null422303/board-rescuer-deck/paper/figures/fig6_detection.png

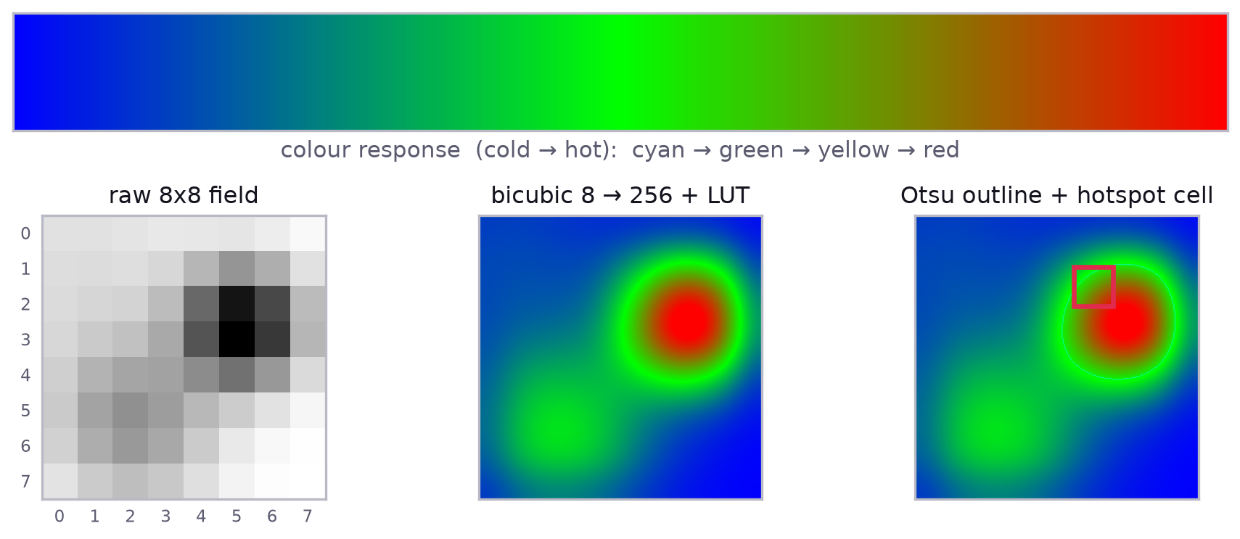
paper/figures/fig6_detection.png
