null422303/board-rescuer-deck/paper/photos/1792234036968.jpg

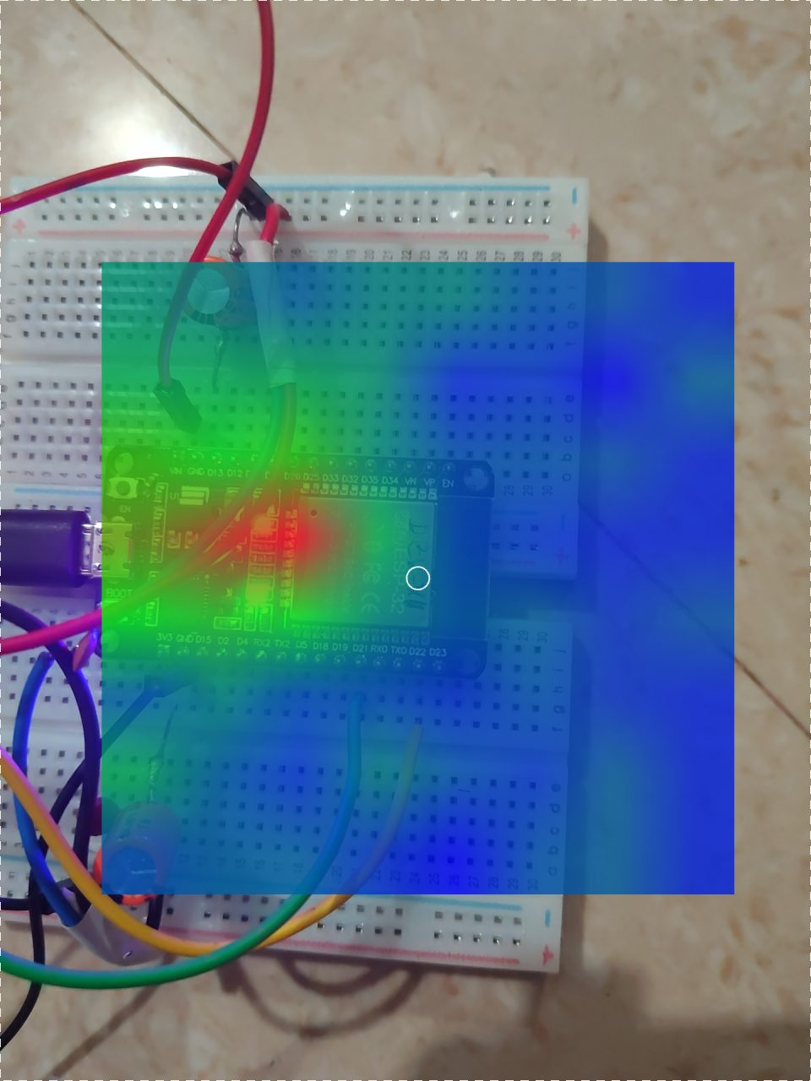
paper/photos/1792234036968.jpg
