null422303/board-rescuer-deck/assets/fx/astro-blocks.gif

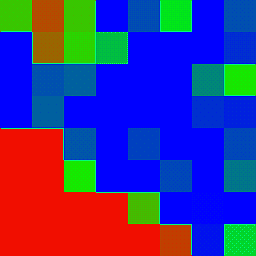
assets/fx/astro-blocks.gif
