null422303/board-rescuer-deck/assets/fx/astro-contour.gif

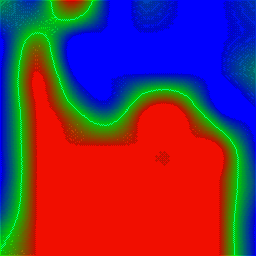
assets/fx/astro-contour.gif
