null422303/board-rescuer-deck/assets/fx/astro-sharp.gif

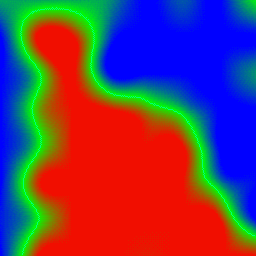
assets/fx/astro-sharp.gif
