null422303/board-rescuer-deck/assets/fx/plain-blocks.gif

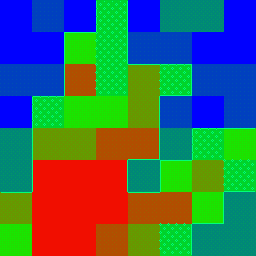
assets/fx/plain-blocks.gif
