null422303/board-rescuer-deck/assets/fx/plain-contour.gif

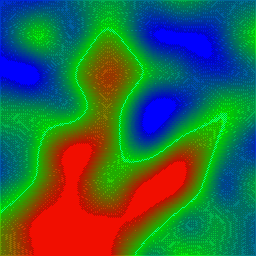
assets/fx/plain-contour.gif
