null422303/board-rescuer-deck/assets/fx/plain-sharp.gif

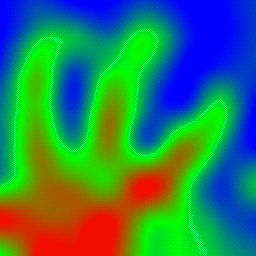
assets/fx/plain-sharp.gif
