null422303/board-rescuer-deck/assets/og.png

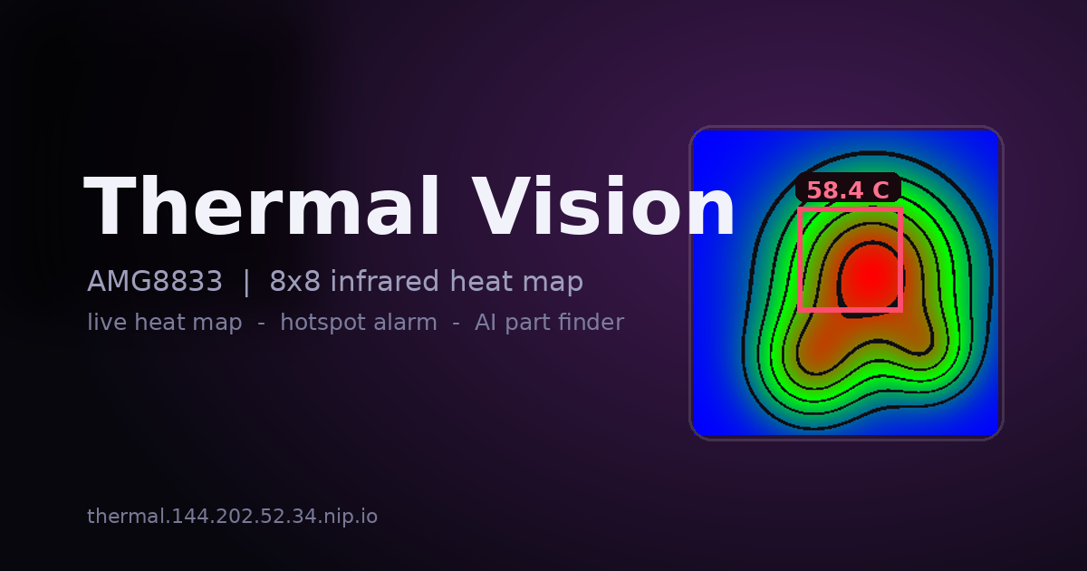
assets/og.png
