null422303/board-rescuer-deck/paper/figures/col_injection.png

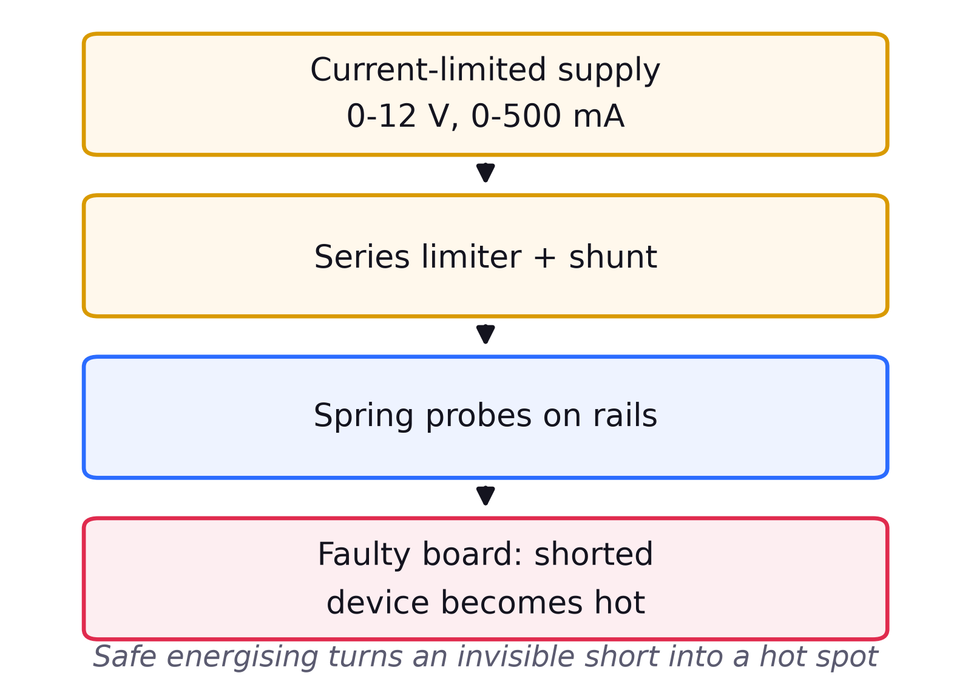
paper/figures/col_injection.png
