null422303/board-rescuer-deck/paper/figures/col_packet.png

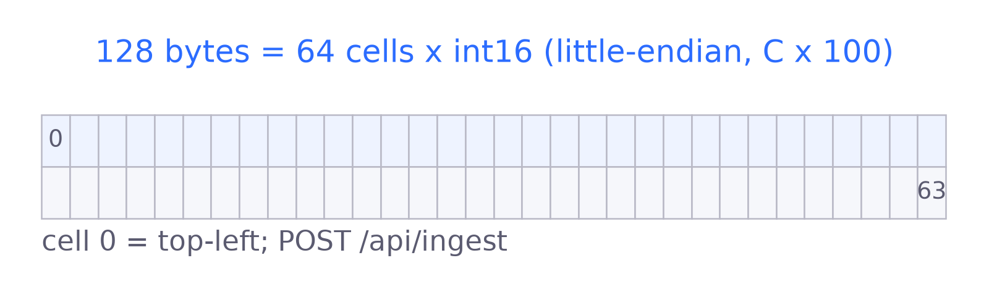
paper/figures/col_packet.png
