null422303/board-rescuer-deck/paper/figures/col_pipeline.png

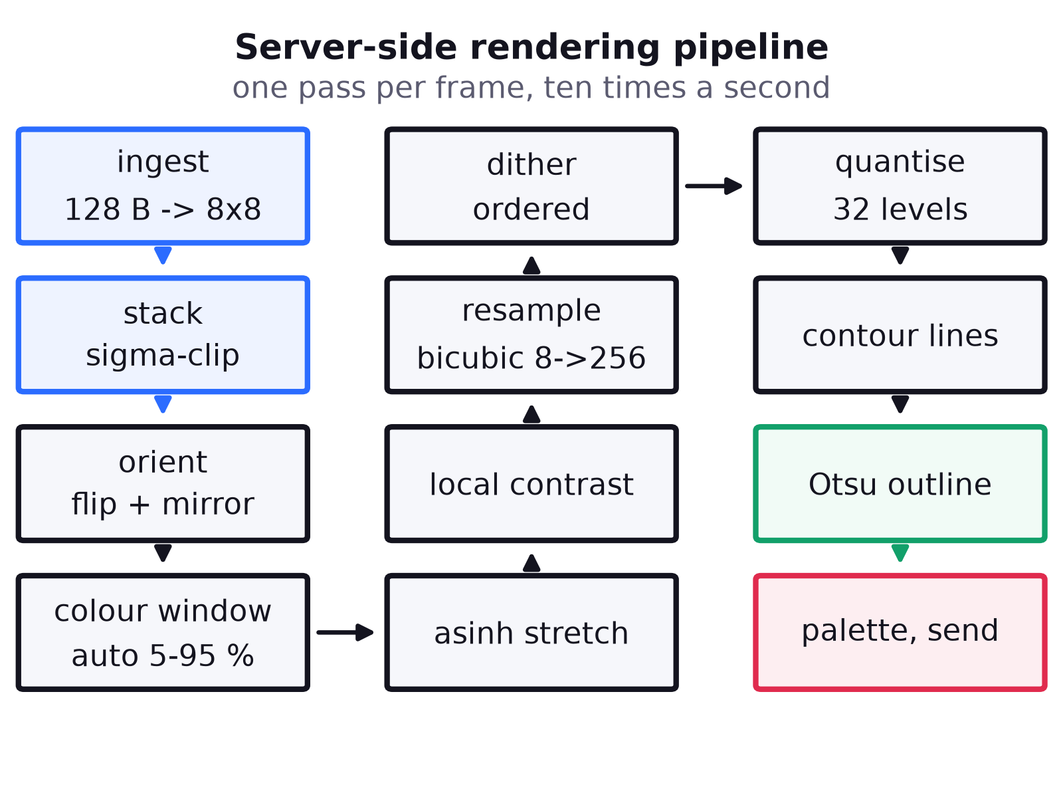
paper/figures/col_pipeline.png
