null422303/board-rescuer-deck/paper/figures/col_schematic.png

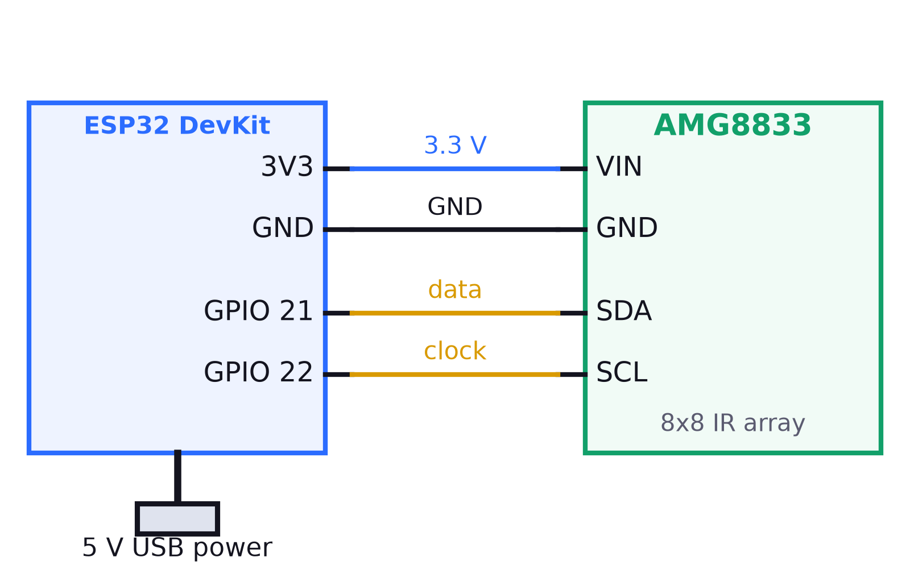
paper/figures/col_schematic.png
