null422303/board-rescuer-deck/paper/figures/fig1_architecture.png

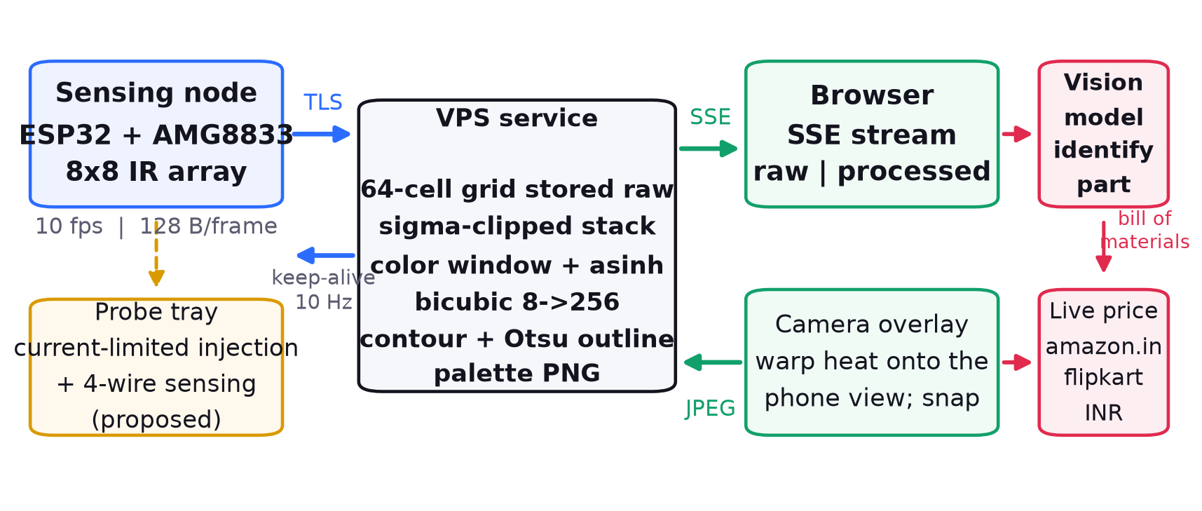
paper/figures/fig1_architecture.png
