null422303/board-rescuer-deck/paper/figures/fig2_schematic.png

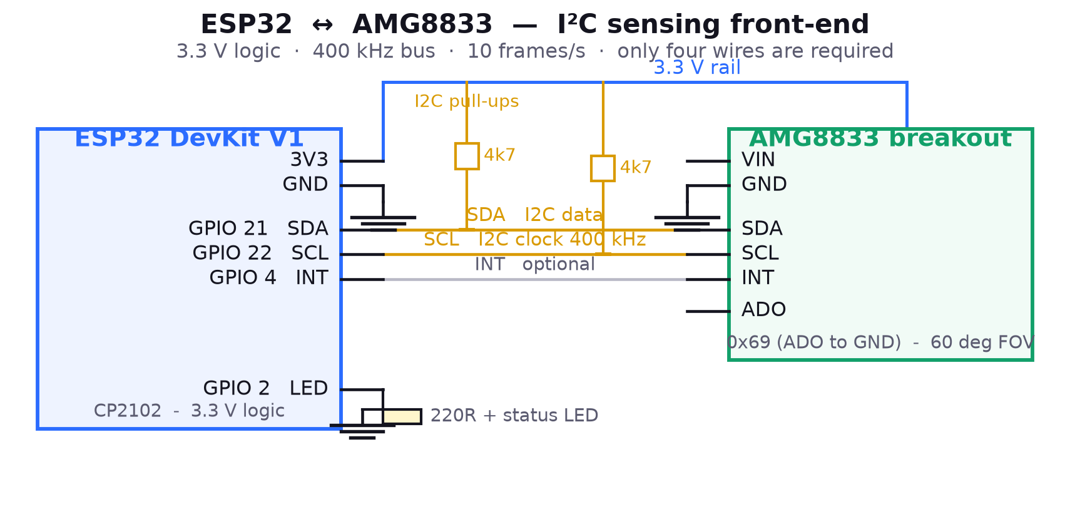
paper/figures/fig2_schematic.png
