null422303/board-rescuer-deck/paper/figures/fig3_injection.png

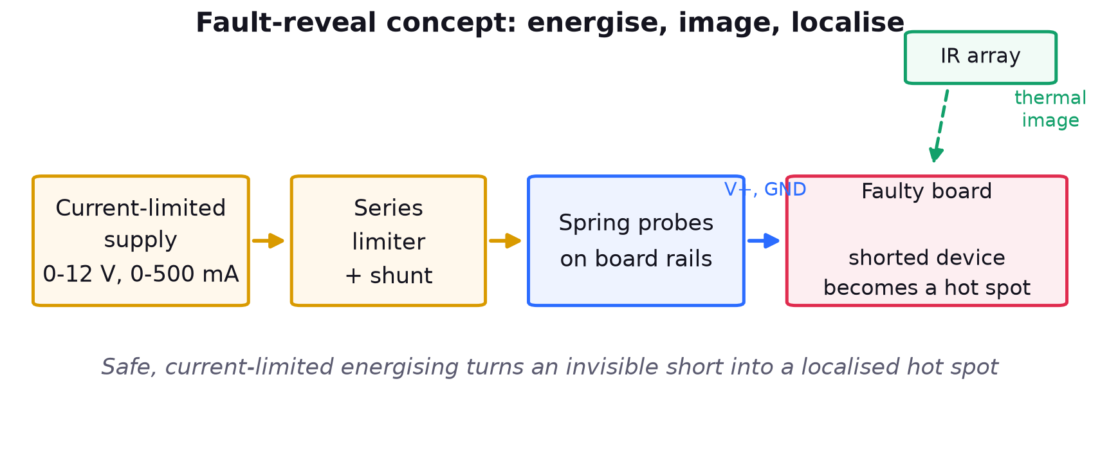
paper/figures/fig3_injection.png
