null422303/board-rescuer-deck/paper/figures/fig4_packet.png

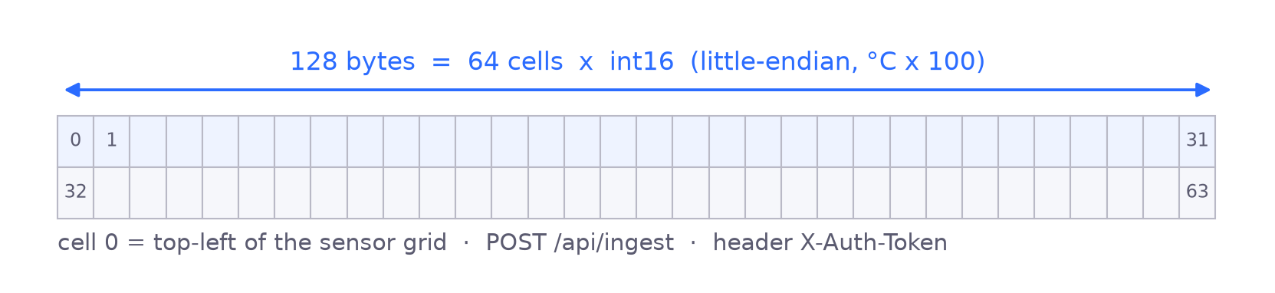
paper/figures/fig4_packet.png
