null422303/board-rescuer-deck/paper/figures/fig5_pipeline.png

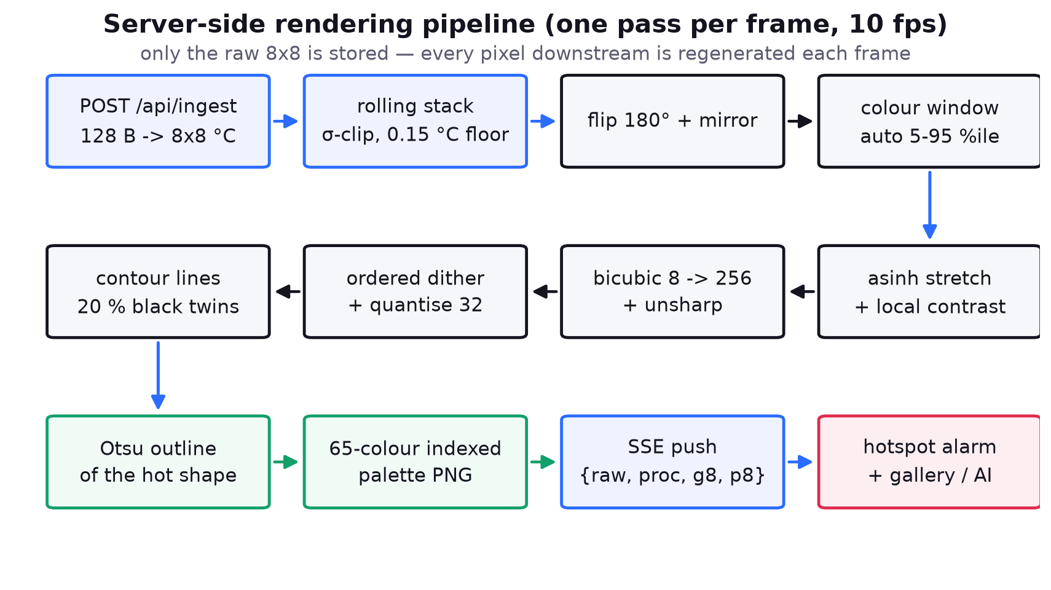
paper/figures/fig5_pipeline.png
