null422303/board-rescuer-deck/(commit log)

2026-10-18 The Right-to-Repair Board Rescuer Deck: ESP32 + AMG8833 thermal node, server-side renderer, camera overlay, identification
2026-10-18 Paper: Johnsteven R centred on top, Maarthi P first on second row; LED wording; code cited as ref [1]; /paper route
2026-10-18 Captions sized to their figures and kept attached; Figs 6 and 7 enlarged
2026-10-18 Drop reference list for a single code note; fit four pages with no passage cut
